ogatatsu/BL652-breakout/schematic.pdf

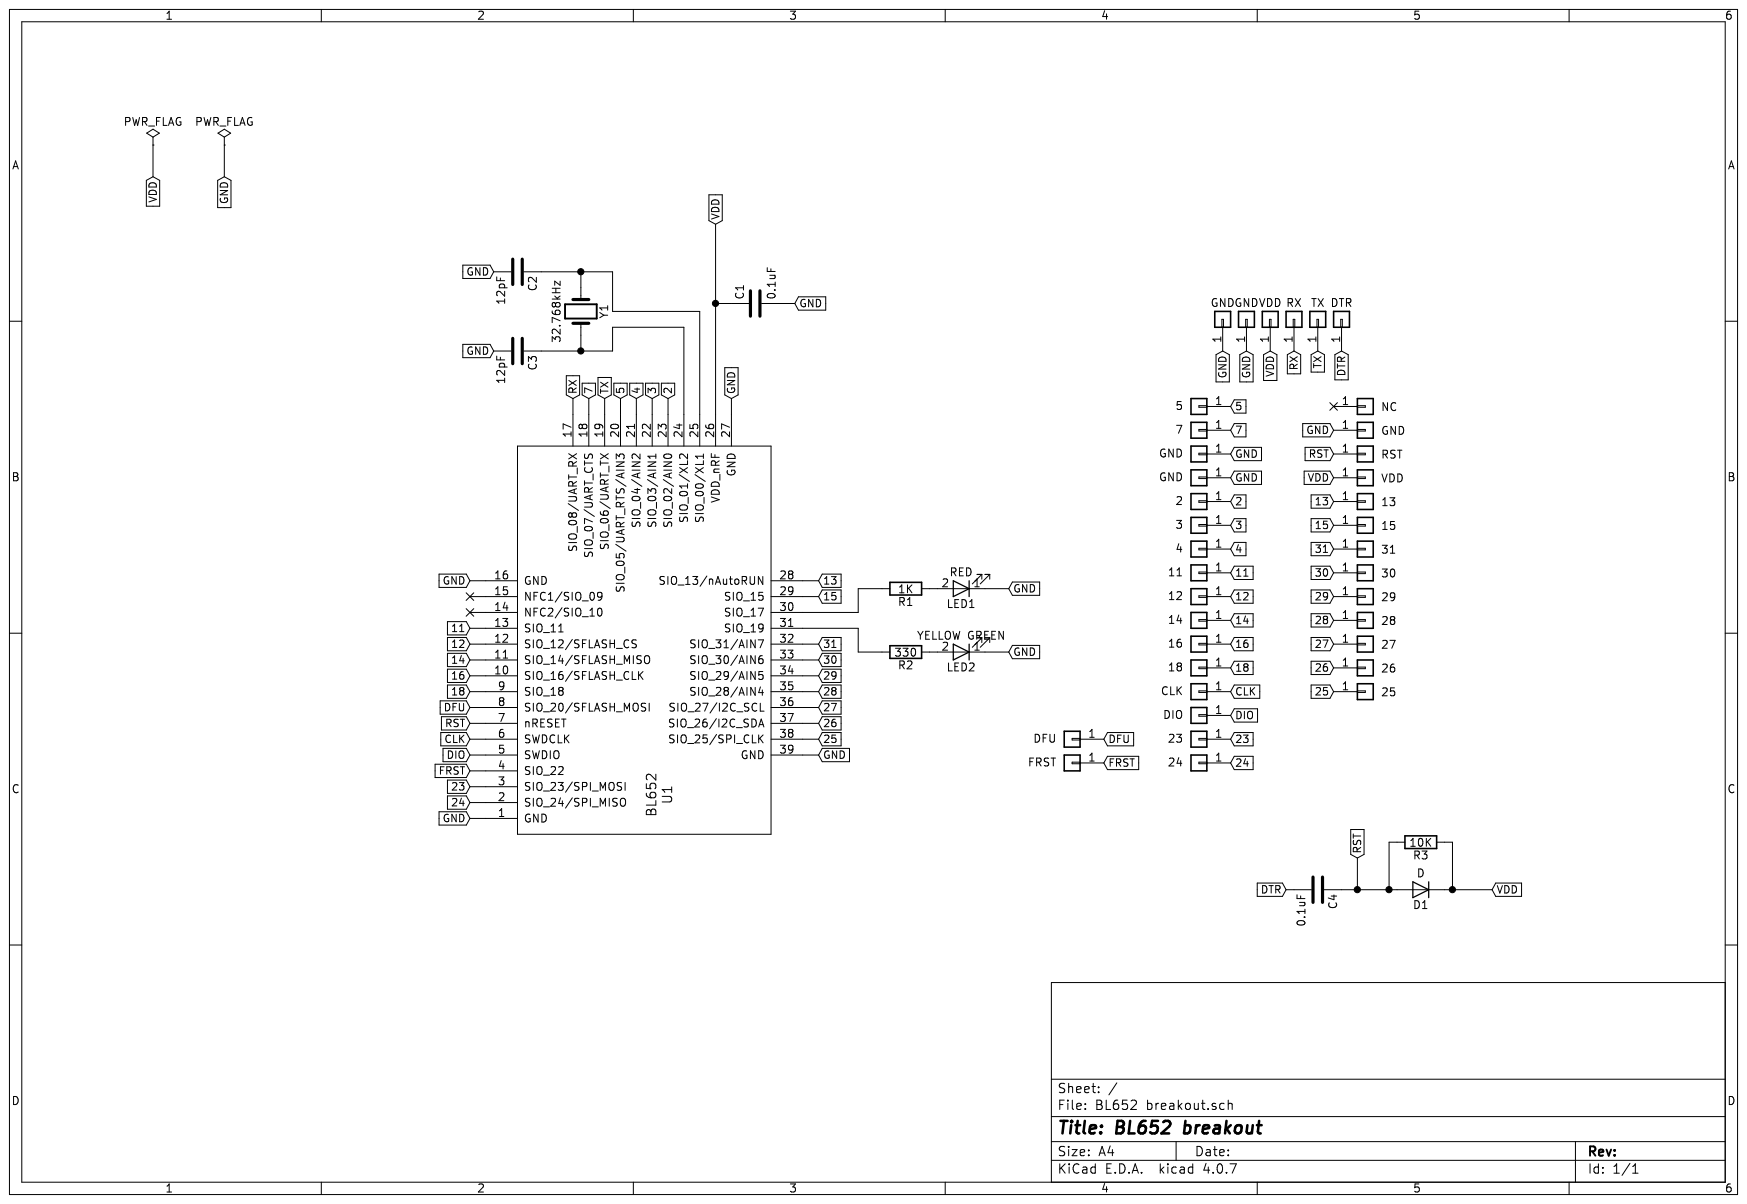
[picture p4: page 1]
