ogatatsu/BL652-breakout/BL652 breakout.kicad_pcb

## KiCad design BL652 breakout.kicad_pcb (2018-01-12)

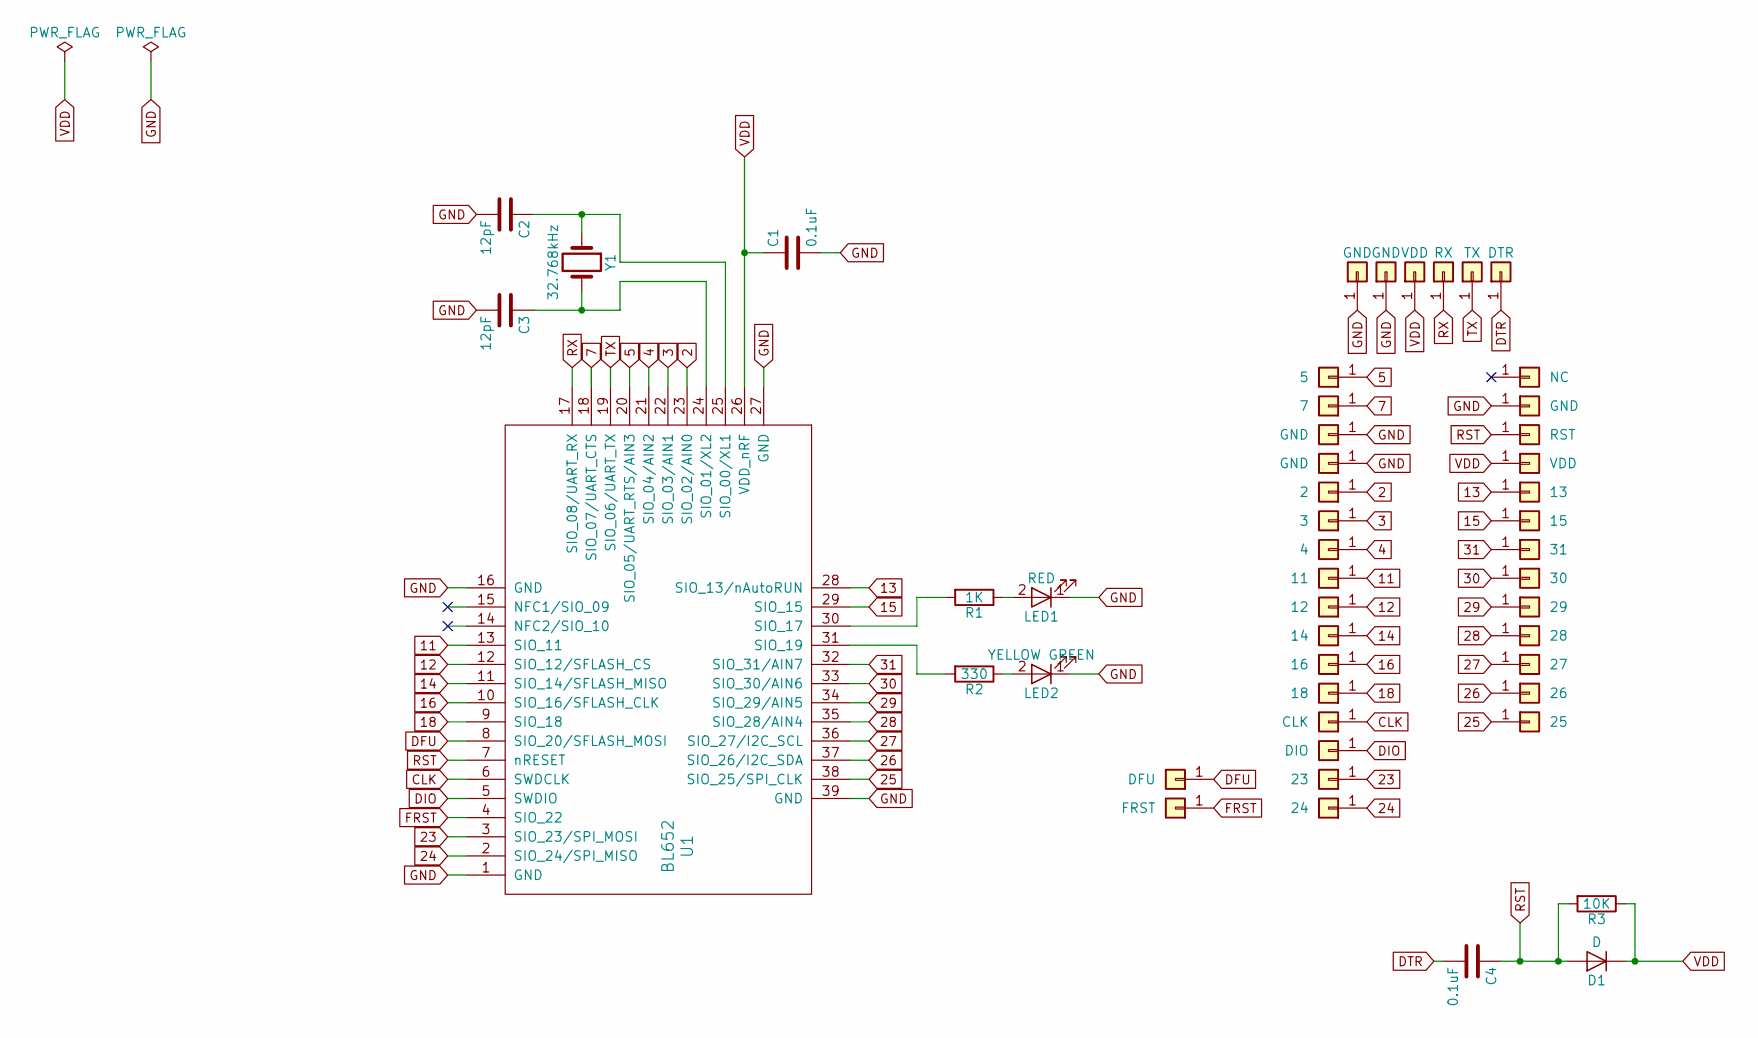
[picture p5: schematic BL652 breakout.sch]

Parts:
C1, C4: 0.1uF; 1608
C2, C3: 12pF; 1608
D1: D; Diode
LED1: RED; 1608
LED2: YELLOW GREEN; 1608
P2: 2; Wirepad
P3: 3; Wirepad
P4: 4; Wirepad
P5: 5; Wirepad
P7: 7; Wirepad
P11: 11; Wirepad
P12: 12; Wirepad
P13: 13; Wirepad
P14: 14; Wirepad
P15: 15; Wirepad
P16: 16; Wirepad
P18: 18; Wirepad
P23: 23; Wirepad
P24: 24; Wirepad
P25: 25; Wirepad
P26: 26; Wirepad
P27: 27; Wirepad
P28: 28; Wirepad
P29: 29; Wirepad
P30: 30; Wirepad
P31: 31; Wirepad
PCLK1: CLK; Wirepad
PDFU1: DFU; Circle
PDIO1: DIO; Wirepad
PDTR1: DTR; Wirepad
PFRST1: FRST; Circle
PGND1, PGND2, PGND3, PGND4, PGND5: GND; Wirepad
PNC2: NC; Wirepad
PRST1: RST; Wirepad
PRX1: RX; Wirepad
PTX1: TX; Wirepad
PVDD1, PVDD2: VDD; Wirepad
R1: 1K; 1608
R2: 330; 1608
R3: 10K; 1608
U1: BL652
Y1: 32.768kHz; FC-135

Connections:
2: P2.1, U1.23 (SIO_02/AIN0)
3: P3.1, U1.22 (SIO_03/AIN1)
4: P4.1, U1.21 (SIO_04/AIN2)
5: P5.1, U1.20 (SIO_05/UART_RTS/AIN3)
7: P7.1, U1.18 (SIO_07/UART_CTS)
11: P11.1, U1.13 (SIO_11)
12: P12.1, U1.12 (SIO_12/SFLASH_CS)
13: P13.1, U1.28 (SIO_13/nAutoRUN)
14: P14.1, U1.11 (SIO_14/SFLASH_MISO)
15: P15.1, U1.29 (SIO_15)
16: P16.1, U1.10 (SIO_16/SFLASH_CLK)
18: P18.1, U1.9 (SIO_18)
23: P23.1, U1.3 (SIO_23/SPI_MOSI)
24: P24.1, U1.2 (SIO_24/SPI_MISO)
25: P25.1, U1.38 (SIO_25/SPI_CLK)
26: P26.1, U1.37 (SIO_26/I2C_SDA)
27: P27.1, U1.36 (SIO_27/I2C_SCL)
28: P28.1, U1.35 (SIO_28/AIN4)
29: P29.1, U1.34 (SIO_29/AIN5)
30: P30.1, U1.33 (SIO_30/AIN6)
31: P31.1, U1.32 (SIO_31/AIN7)
CLK: PCLK1.1, U1.6 (SWDCLK)
DFU: PDFU1.1, U1.8 (SIO_20/SFLASH_MOSI)
DIO: PDIO1.1, U1.5 (SWDIO)
DTR: C4.2, PDTR1.1
FRST: PFRST1.1, U1.4 (SIO_22)
GND: C1.2, C2.2, C3.2, LED1.1 (K), LED2.1 (K), PGND1.1, PGND2.1, PGND3.1, PGND4.1, PGND5.1, U1.1 (GND), U1.16 (GND), U1.27 (GND), U1.39 (GND)
unnamed: C2.1, U1.25 (SIO_00/XL1), Y1.1
unnamed: C3.1, U1.24 (SIO_01/XL2), Y1.2
unnamed: LED1.2 (A), R1.1
unnamed: LED2.2 (A), R2.1
unnamed: R1.2, U1.30 (SIO_17)
unnamed: R2.2, U1.31 (SIO_19)
RST: C4.1, D1.2 (A), PRST1.1, R3.2, U1.7 (nRESET)
RX: PRX1.1, U1.17 (SIO_08/UART_RX)
TX: PTX1.1, U1.19 (SIO_06/UART_TX)
VDD: C1.1, D1.1 (K), PVDD1.1, PVDD2.1, R3.1, U1.26 (VDD_nRF)

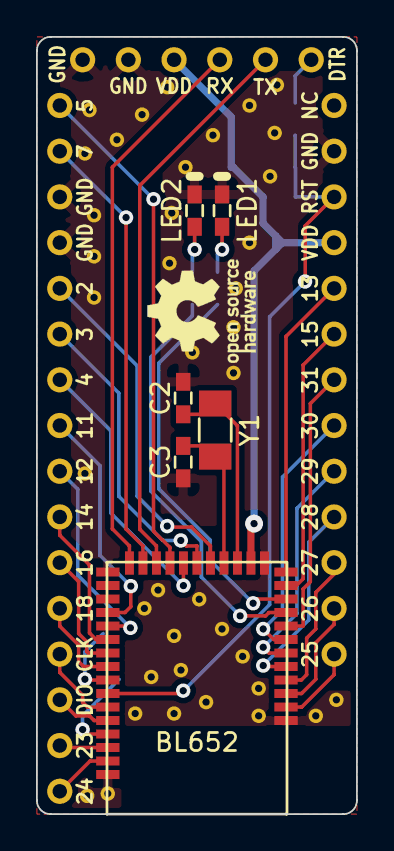
[picture p6: board BL652 breakout.kicad_pcb from above]

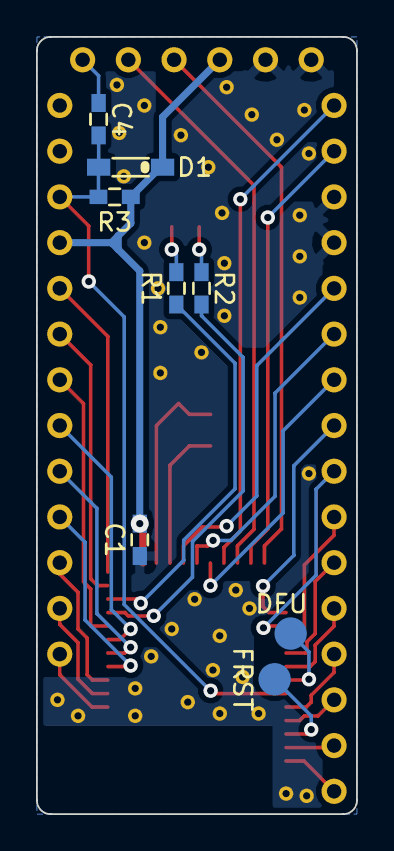
[picture p7: board BL652 breakout.kicad_pcb from below]

Board: 2 copper layers, 17.8 x 43.2 mm, 49 parts (8 on the bottom side), 37 nets.
